Neelkanth27/jalrakshak/docs/cad/enclosure_preview.png

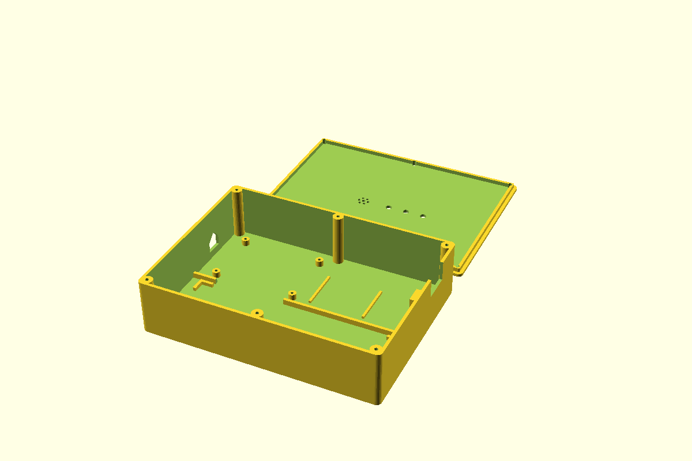
docs/cad/enclosure_preview.png
