Neelkanth27/jalrakshak/docs/cad/jalrakshak_enclosure_lid.stl

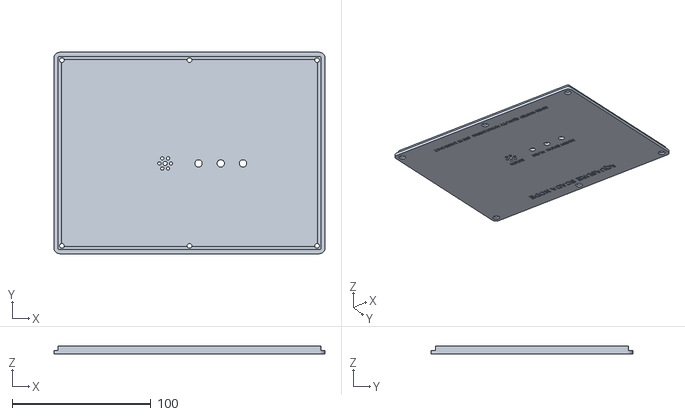
[picture p2: CAD file, 2026-11-10]
docs/cad/jalrakshak_enclosure_lid.stl
195.0 x 145.0 x 6.00
