Neelkanth27/jalrakshak/docs/cad/jalrakshak_enclosure_base.stl

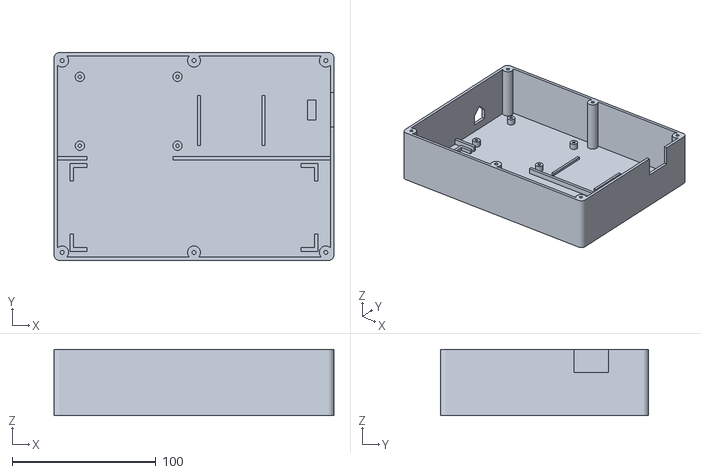
[picture p3: CAD file, 2026-11-10]
docs/cad/jalrakshak_enclosure_base.stl
195.0 x 145.0 x 46.0
