Neelkanth27/jalrakshak/docs/cad/export_base.scad

use <jalrakshak_enclosure.scad>

// 100% Support-Free Production Base (Self-supporting 45-degree peaked USB lintel)
enclosure_base(with_built_in_supports = false);
