Neelkanth27/jalrakshak/docs/cad/export_base_supported.scad

use <jalrakshak_enclosure.scad>

// Pre-supported variant with built-in 0.4mm breakaway sacrificial support ribs
enclosure_base(with_built_in_supports = true);
