Neelkanth27/jalrakshak/docs/cad/export_full_assembly.scad

use <jalrakshak_enclosure.scad>

// Both parts laid out flat side-by-side on the build plate (Z=0)
enclosure_full_assembly();
