Neelkanth27/jalrakshak/(list of files, cad)

Other CAD files:
docs/cad/jalrakshak_enclosure_base_with_supports.stl
