Neelkanth27/jalrakshak/(commit log)

2026-10-31 fix(dashboard): load rolling history on mount and ensure continuous SVG trendline rendering
2026-10-31 feat(dashboard): add top-level historical records and audit log table with search and filtering
2026-10-31 fix(dashboard): resolve chart label overlap with left Y-axis gutter and relocate HistoryTable to bottom
2026-10-31 feat(security): enforce X-Device-Key cryptographic header validation on telemetry ingestion
2026-10-31 docs: update client runbook with laptop 5V USB power profile and X-Device-Key cloud security
2026-11-01 fix(cloud): add pg8000 pure-python driver, /tmp SQLite fallback, and resilient database connection
2026-11-01 fix(db): strip unsupported channel_binding parameter for Neon pg8000 driver
2026-11-03 feat(firmware): add production ESP32 firmware, Arduino sketch, and hardware defense guide
2026-11-04 feat(firmware): optimize OLED driver for 1.3 inch SH1106 display
2026-11-04 fix(firmware): declare WaterDiagnosis struct at top for Arduino IDE preprocessor
    [firmware.ino, main.cpp]
2026-11-04 fix(firmware): isolate firmware.ino from platformio source to prevent duplicate symbol linker collisions
    [main.cpp]
2026-11-04 fix(firmware): move platformio code outside firmware folder to ensure 100% clean Arduino IDE build
    [main.cpp]
2026-11-04 fix(firmware): add tone/noTone audio wave generation for passive/active buzzer compatibility
    [firmware.ino, main.cpp]
2026-11-04 fix(firmware): add automatic 0x3C/0x3D I2C address detection for OLED display
    [firmware.ino, main.cpp]
2026-11-04 feat(firmware): add automatic I2C hardware bus scanner and 100kHz bus stabilization
2026-11-04 feat(firmware): add universal dual SSD1306 and SH1106 auto-driver initialization
2026-11-04 feat(firmware): add automatic I2C pin-swap fallback (SDA/SCL) and M-130-12864 support
    [firmware.ino]
2026-11-04 feat(firmware): prioritize native SH1106 driver at 100kHz for M-130-12864 1.3 inch OLED
2026-11-04 fix(firmware): add ESP32 Wire.setPins lock, direct hardware wake-up sequence, and 300ms verification flash
    [firmware.ino]
2026-11-04 feat(firmware): log explicit I2C transmission error return codes for OLED wake-up and flash
    [firmware.ino]
2026-11-04 fix(firmware): clean I2C bus state and add diagnostic perimeter rectangle on OLED boot
    [firmware.ino]
2026-11-04 fix(firmware): implement universal hardware SH1106 driver with atomic I2C commands and verification flash
    [firmware.ino]
2026-11-04 feat(firmware): add industrial alarm acknowledge and mute button support via BOOT button and GPIO13
2026-11-04 feat(ui,api,firmware): add remote Web and Phone app buzzer mute and alarm acknowledge button
    [firmware.ino]
2026-11-05 fix(firmware,api): persist alarm mute state in Neon Postgres and optimize ESP32 substring cloud command parsing
    [firmware.ino]
2026-11-05 feat(ui,firmware): add bidirectional toggle to turn buzzer ON and OFF from web dashboard
    [firmware.ino]
2026-11-05 feat(firmware): add debounced hardware button toggle for buzzer mute/unmute
    [firmware.ino]
2026-11-05 feat(firmware): log raw turbidity voltage for sensor alignment and calibration
2026-11-05 feat(firmware): log both turbidity and tds voltages for bench test verification
2026-11-05 refactor(firmware): remove OLED initialization and I2C scanning for clean instant headless boot
2026-11-05 fix(firmware): calibrate turbidity for 3.3V power and align WQI to BIS IS 10500 standards
    [firmware.ino]
2026-11-05 fix(firmware): add EMA filter and Schmitt-trigger hysteresis to eliminate LED flickering
    [firmware.ino]
2026-11-05 fix(firmware): tune clean tap water baseline to prevent false alarms
    [firmware.ino]
2026-11-05 chore(firmware): add direct raw ADC diagnostic logging and responsive EMA
2026-11-05 docs(cad): add complete 3D printable parametric enclosure model and assembly guide
    [jalrakshak_enclosure.scad]
2026-11-06 fix(calibration): calibrate TDS & Turbidity thresholds for 3.3V analog op-amp ceiling
    [firmware.ino, main.cpp]
2026-11-06 feat(ui): restrict siren mute button interactivity to ALARM state and keep WARNING purely visual
2026-11-06 docs(handbook): update TDS probe color to white, add Wi-Fi configuration guide and enclosure driver bay layout
    [jalrakshak_enclosure.scad]
2026-11-06 feat(cad): generate watertight 3D printable STL files for base and lid
    [export_base.scad, export_full_assembly.scad, export_lid.scad, jalrakshak_enclosure.scad, jalrakshak_enclosure_base.stl, jalrakshak_enclosure_lid.stl]
2026-11-06 docs: polish README with quick links to live PWA, PDF manuals, and CAD models
2026-11-10 fix(cad): isolate base and lid STLs and pre-orient lid flat on print bed to eliminate overhangs
    [export_full_assembly.scad, export_lid.scad, jalrakshak_enclosure.scad, jalrakshak_enclosure_base.stl, jalrakshak_enclosure_lid.stl]
2026-11-10 fix(cad): default PART_TO_PRINT to both for instant preview and merge standoffs for manifold STL export
    [export_base.scad, export_full_assembly.scad, export_lid.scad, jalrakshak_enclosure.scad, jalrakshak_enclosure_base.stl, jalrakshak_enclosure_lid.stl]
2026-11-10 feat(cad): expand enclosure to 195x145x48mm for full-size 830-point breadboard and ESP32 shield with generous wire clearance
    [jalrakshak_enclosure.scad, jalrakshak_enclosure_base.stl, jalrakshak_enclosure_lid.stl]
2026-11-10 feat(cad): add 100% self-supporting 45-deg USB lintel, clustered layout for short wires, and pre-supported base STL for vendor
    [export_base.scad, export_base_supported.scad, jalrakshak_enclosure.scad, jalrakshak_enclosure_base.stl, jalrakshak_enclosure_base_with_supports.stl, jalrakshak_enclosure_lid.stl]
2026-11-10 chore(branding): rebrand project to AquaSure across CAD lid, firmware, cloud SCADA, and PDF manuals
    [jalrakshak_enclosure.scad, jalrakshak_enclosure_lid.stl]
